niklasbuechner/autonome-mobile-roboter/integration/Pinbelegung Skizze.pdf

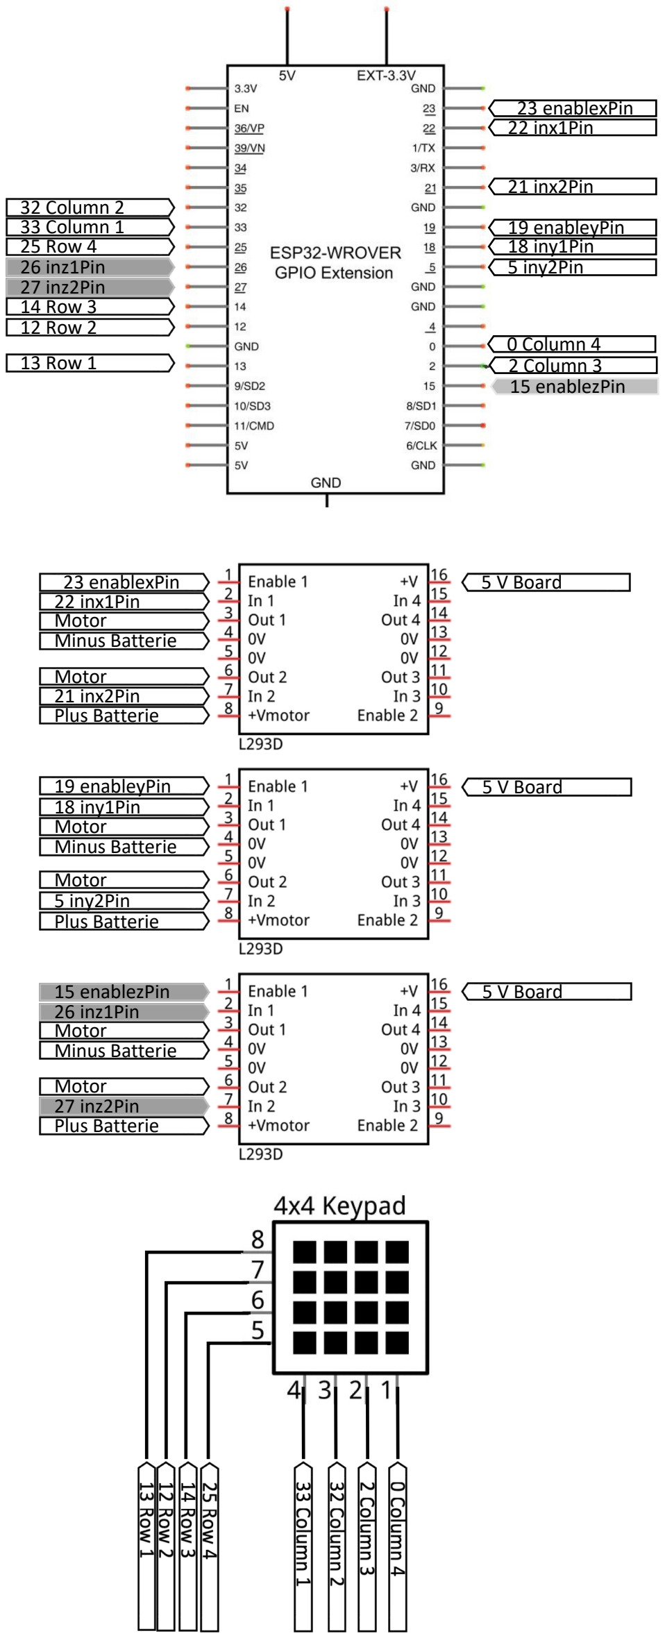
[picture p16: page 1]

23 enablexPin
22 inx1Pin

21 inx2Pin
19 enableyPin
18 iny1Pin
5 iny2Pin

13 Row 1

14 Row 3

25 Row 4

12 Row 2

33 Column 1

32 Column 2

2 Column 3

0 Column 4

23 enablexPin
22 inx1Pin

21 inx2Pin

Motor

Motor

Motor

Motor

Motor

Motor

Minus Batterie

Minus Batterie

Minus Batterie

Plus Batterie

Plus Batterie

Plus Batterie

5 V Board

5 V Board

5 V Board

19 enableyPin
18 iny1Pin

5 iny2Pin

15 enablezPin

26 inz1Pin
27 inz2Pin

15 enablezPin
26 inz1Pin

27 inz2Pin

## Dass Farben leicht unterschiedlich sind ist Produktionsbedingt

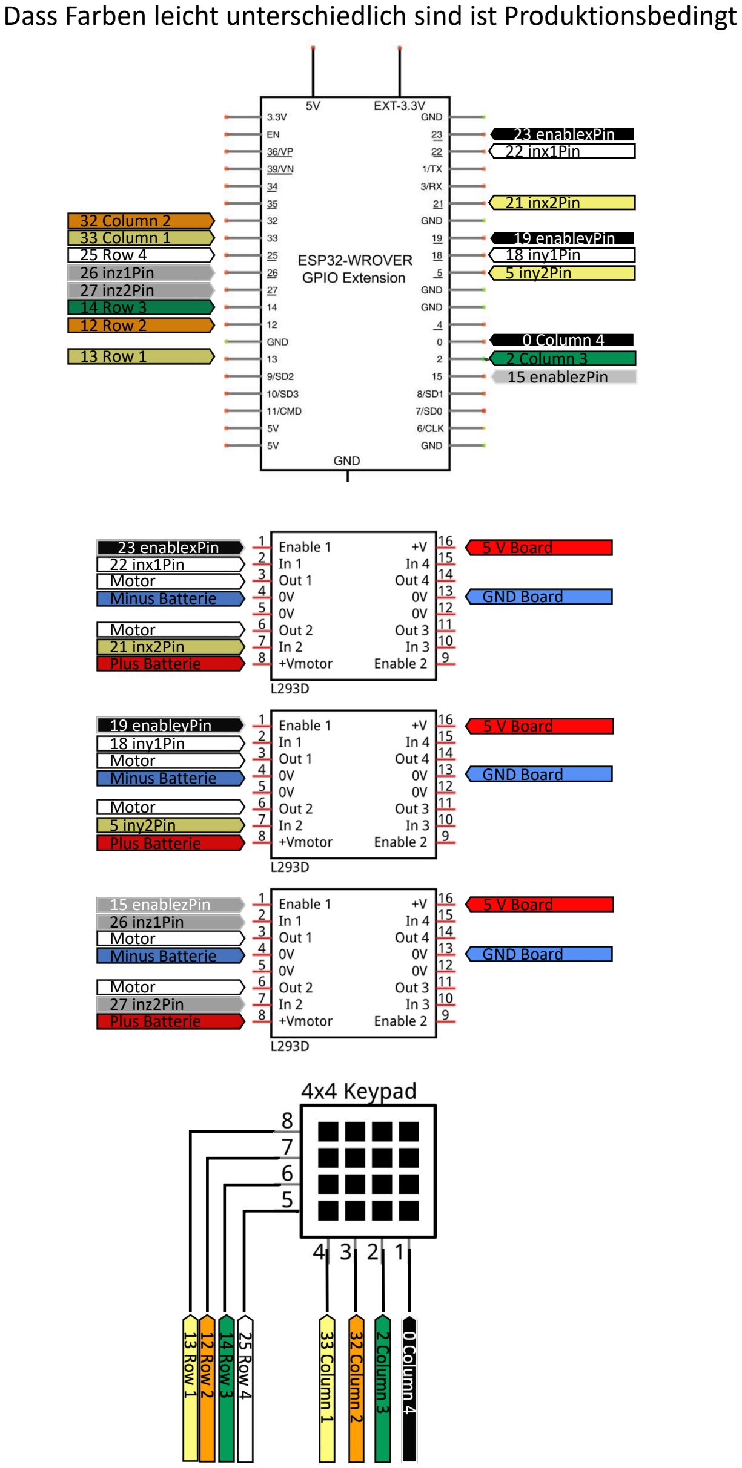
[picture p17: page 2]

23 enablexPin
22 inx1Pin

21 inx2Pin
19 enableyPin
18 iny1Pin
5 iny2Pin

13 Row 1

14 Row 3

25 Row 4

12 Row 2

33 Column 1

32 Column 2

2 Column 3

0 Column 4

23 enablexPin
22 inx1Pin

21 inx2Pin

Motor

Motor

Motor

Motor

Motor

Motor

Minus Batterie

Minus Batterie

Minus Batterie

Plus Batterie

Plus Batterie

Plus Batterie

5 V Board

5 V Board

5 V Board

19 enableyPin
18 iny1Pin

5 iny2Pin

15 enablezPin

26 inz1Pin
27 inz2Pin

15 enablezPin
26 inz1Pin

27 inz2Pin

GND Board

GND Board

GND Board

Eigentlich weiß

## Das Graue ist eigentlich weiß Das ist ein Skizze. Die genauen Reihen stimmen nicht

## Entlang der schwarzen Linien ist dasselbe Potential (Spannung) und

entlang der roten auch. Nicht über Mittellinie hinaus.

## D.h. wenn ein Kabel in eine der 5 Öffnungen geht und ein anderes aus

einem anderen der 5 raus geht ist dort dieselbe Spannung (siehe Bsp.

## In orange und pink) Außen (grün, gelb, blau, lila) sind die Spannungen vertikal über das

ganze Board gleich. Links (grün) liegen 5 V an, Rechts (hellblau) 3,3 V.

0 V 0 V 5 V 5 V

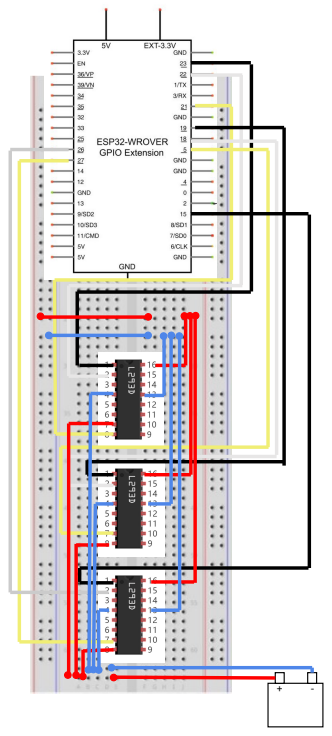
[picture p18: page 4]
