niklasbuechner/autonome-mobile-roboter/Präsentation/AMR_Präsentation.pdf

# Fakultät für Informatik

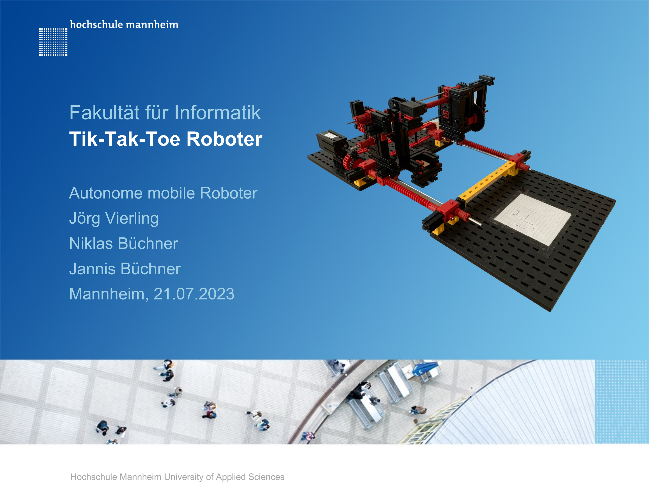
[picture p19: page 1]

Hochschule Mannheim University of Applied Sciences

# Tik-Tak-Toe Roboter

# Autonome mobile Roboter Jörg Vierling Niklas Büchner Jannis Büchner Mannheim, 21.07.2023

# Mechanik: x-Achse

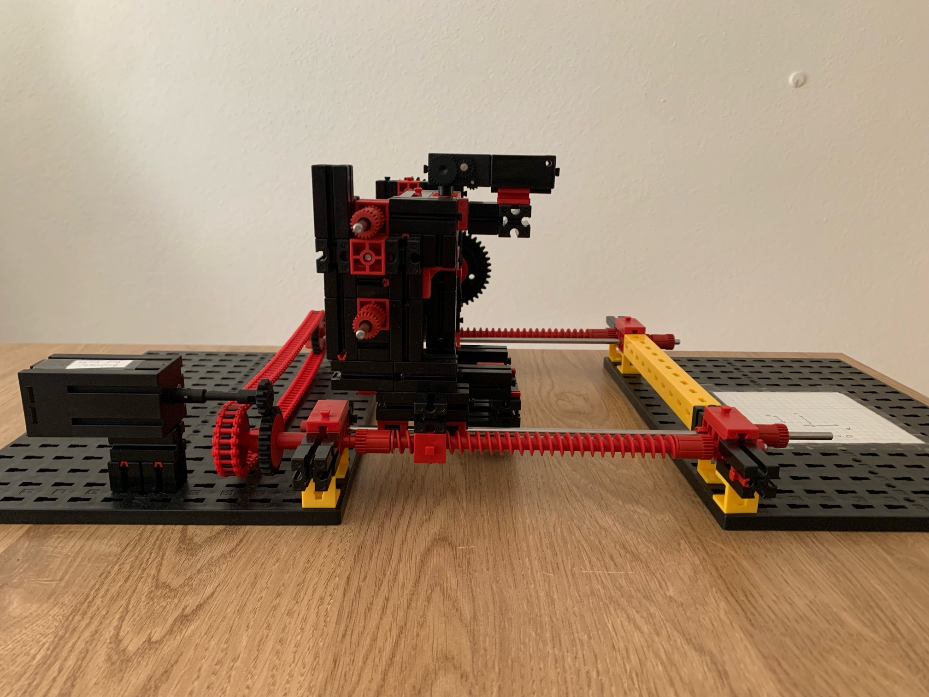
[picture p20: figure]

Hochschule Mannheim University of Applied Sciences | 2

# Mechanik: y-Achse

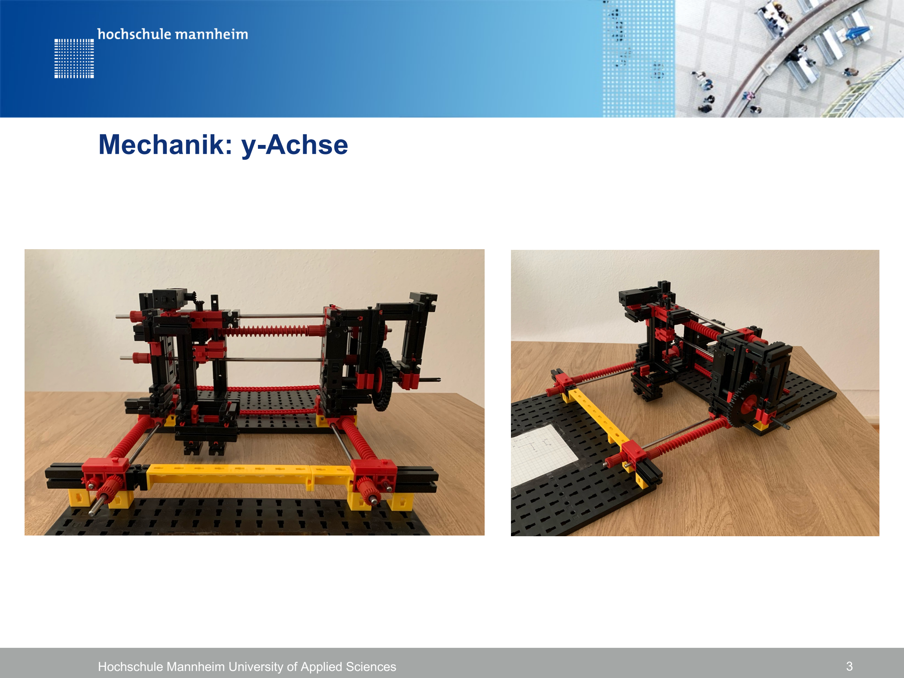
[picture p21: page 3]

# Mechanik: z-Achse

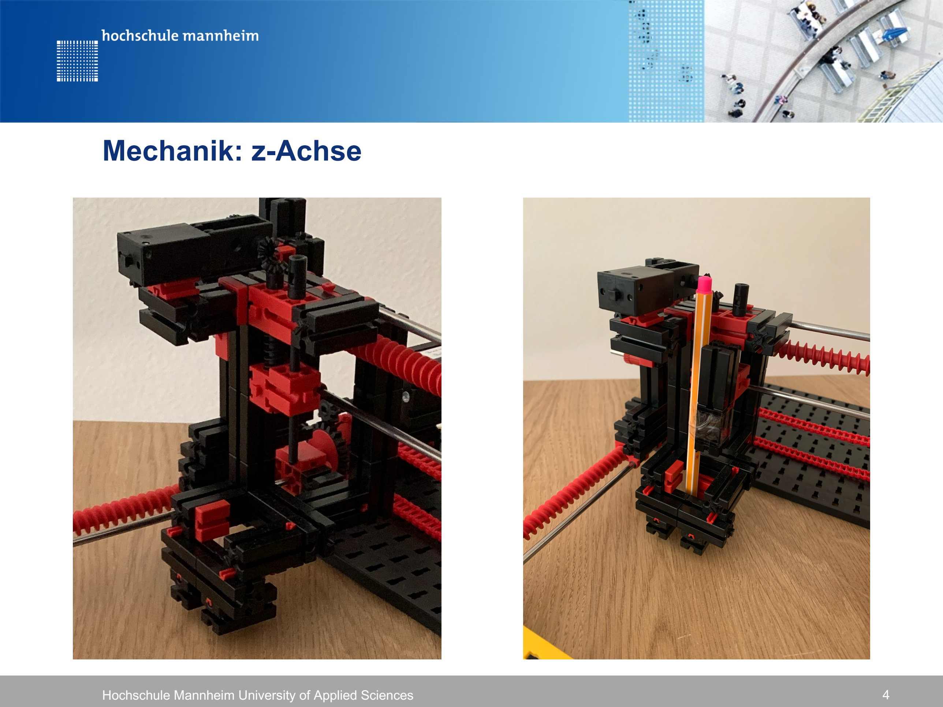
[picture p22: page 4]

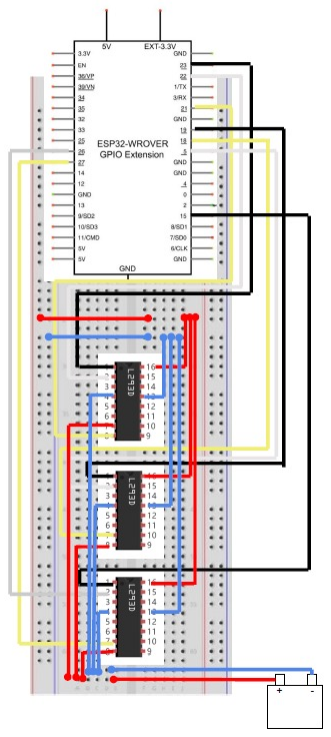
[picture p23: figure]

# Elektrik: Schaltplan

# Elektrik: Driver

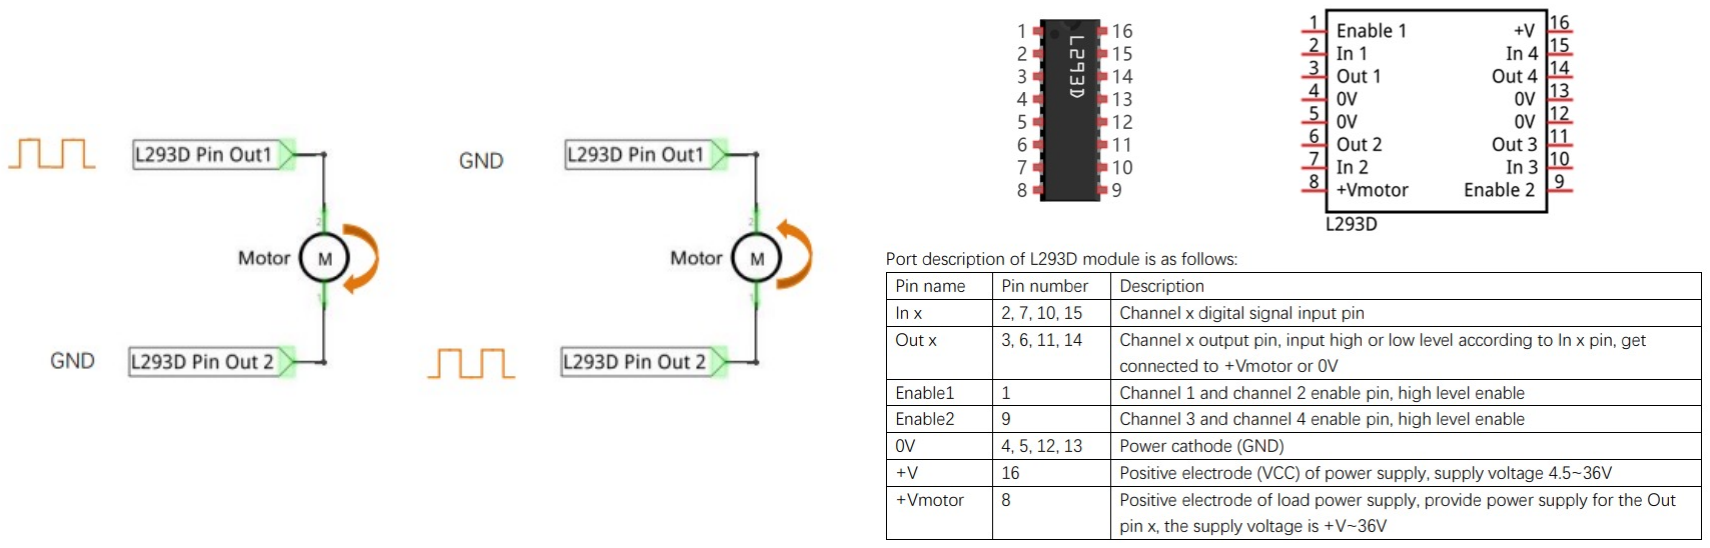
[picture p24: figure]

# Softwaresteuerung

# Ende
