niklasbuechner/autonome-mobile-roboter/document/latex/images/board2.png

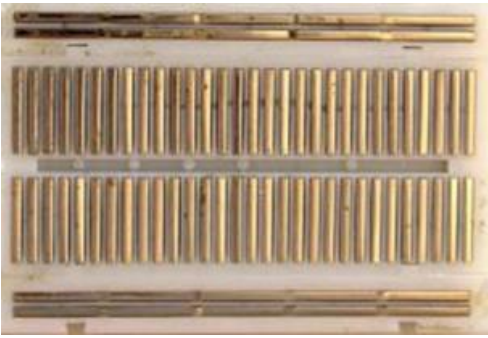
document/latex/images/board2.png
