niklasbuechner/autonome-mobile-roboter/document/latex/images/yAchse.png

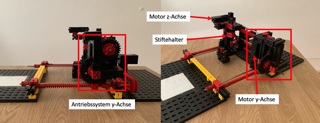
document/latex/images/yAchse.png
