niklasbuechner/autonome-mobile-roboter/document/latex/images/zAchse.png

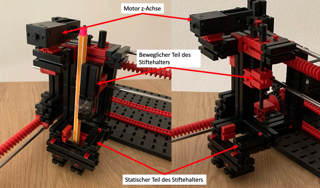
document/latex/images/zAchse.png
