niklasbuechner/autonome-mobile-roboter/(commit log)

2023-04-24 Steuerbarer Motor
2023-05-07 Update UpAndDown.ino
    Support 2 Drivers
2023-06-14 Add Jannis' current text
